FriesW/sauna-controller/logic_gates.png

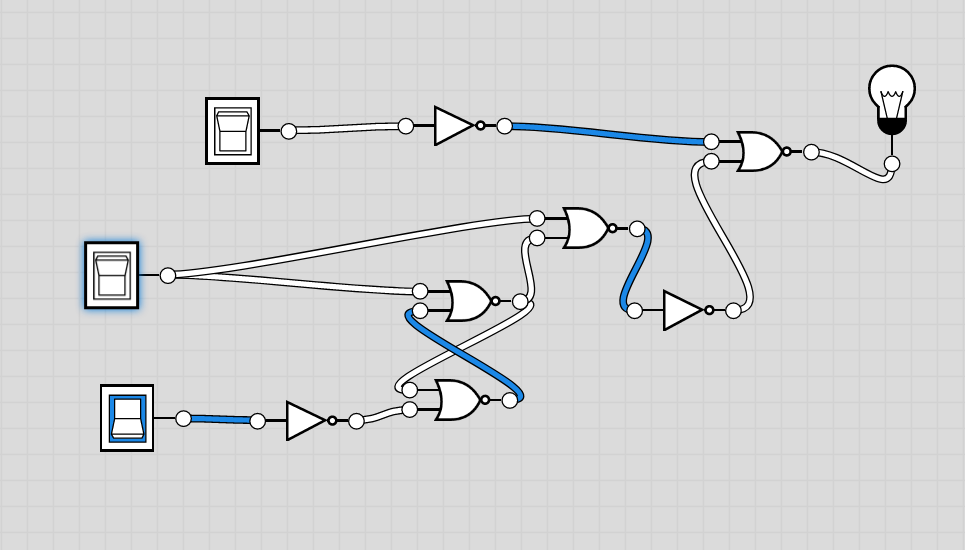
logic_gates.png
