FriesW/sauna-controller/bom.ods

Sheet: Draft
Sch id | Desc | Part # | Link
 | Switch reg | SRH05S12 | https://www.mouser.com/ProductDetail/XP-Power/SRH05S12/?qs=w%2Fv1CP2dgqoB4ok%252BZU%252BVXg%3D%3D
 | Relay | G5V-1-DC12 | https://www.mouser.com/ProductDetail/Omron-Electronics/G5V-1-DC12/
 | Relay | G5Q-1A4-DC12 | https://www.mouser.com/ProductDetail/Omron-Electronics/G5Q-1A4-DC12/?qs=pWf36BUtxBgkyTKYzHU%2F3Q%3D%3D
 | Linear reg | MC78M05CDTG | https://www.mouser.com/ProductDetail/ON-Semiconductor/MC78M05CDTG/?qs=%252B9%2Fcbd0IE0QYxnKZhiUfxQ%3D%3D
 | Rectifier | RABF154-13 | https://www.mouser.com/ProductDetail/Diodes-Incorporated/RABF154-13/?qs=%252BEew9%252B0nqrC87fSpOqlqqA%3D%3D
 | TVS | VESD05A5-06GHG3-08 | https://www.mouser.com/ProductDetail/Vishay-Semiconductors/VESD05A5-06GHG3-08/
 | Flyback Diode | 1N4148WS-HG3-08 | https://www.mouser.com/ProductDetail/Vishay-Semiconductors/1N4148WS-HG3-08/?qs=MLItCLRbWsz%2FnO5zs5RZvA%3D%3D
 | NPN BJT | BC816-25HVL | https://www.mouser.com/ProductDetail/Nexperia/BC816-25HVL/?qs=vmHwEFxEFR%2FYZAQE4AJJ1Q%3D%3D
 | NPN BJT | PMBT2222A,235 | https://www.mouser.com/ProductDetail/Nexperia/PMBT2222A235/?qs=LOCUfHb8d9sTD2Msxc7rRQ%3D%3D
 | Temp sensor | DS18B20+ | https://www.mouser.com/ProductDetail/Maxim-Integrated/DS18B20%2b/?qs=7H2Jq%252ByxpJKegCKabDbglA%3D%3D
 | Board temp sensor | MCP9701AT-E/TT | https://www.mouser.com/ProductDetail/Microchip-Technology/MCP9701AT-E-TT/?qs=yUQqVecv4qtCeX8rF6YxaA%3D%3D
 | Polyfuse | 0ZCF0030FF2C | https://www.mouser.com/ProductDetail/Bel-Fuse/0ZCF0030FF2C/
 | Fusable Resistor | ULW2-10RJA25 | https://www.mouser.com/ProductDetail/Welwyn-Components-TT-Electronics/ULW2-10RJA25/
 | 680 uF HV cap | ELXZ630ELL681MK35S | https://www.mouser.com/ProductDetail/United-Chemi-Con/ELXZ630ELL681MK35S/
 | 4.7 uF HV cap | HMR325AC7475KM-P | https://www.mouser.com/ProductDetail/Taiyo-Yuden/HMR325AC7475KM-P/
 | input inductor | ASPI-6045S-820M-T | https://www.mouser.com/ProductDetail/ABRACON/ASPI-6045S-820M-T/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
 | input inductor | ASPI-4030S-120M-T | https://www.mouser.com/ProductDetail/ABRACON/ASPI-4030S-120M-T/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
 | 220 uF HV cap | EEE-FK1J221AV | https://www.mouser.com/ProductDetail/Panasonic/EEE-FK1J221AV/?qs=4tMhz21N3ZGTStcmMQwx0g%3D%3D
 | 820 uF HV cap | EEE-TP70821M | https://www.mouser.com/ProductDetail/Panasonic/EEE-TP70821M/
 | Watchdog | MIC705MY | https://www.mouser.com/ProductDetail/Microchip-Technology-Micrel/MIC705MY/?qs=kh6iOki%2FeLGGkcTIfRHW3A%3D%3D
 | Temp Sensor | GA10K3A1IA | https://www.mouser.com/ProductDetail/Measurement-Specialties/GA10K3A1IA/?qs=kmv%2FWw32SUNTU3lVb2t0Rg%3D%3D
 | Temp Sensor | NTCLE100E3222HB0 | https://www.mouser.com/ProductDetail/Vishay-BC-Components/NTCLE100E3222HB0/?qs=%2FWiulJ9oly4N3QVFAv7XNQ%3D%3D
 | Temp Sensor | NJ28MA0302F-- | https://www.mouser.com/ProductDetail/AVX/NJ28MA0302F-/?qs=vhKgMu3aMmfBHN8kQbt0PA%3D%3D
 | Post reg cap | `865080445010 | https://www.mouser.com/ProductDetail/Wurth-Elektronik/865080445010/
 | TVS | SP0505BAHTG | https://www.mouser.com/ProductDetail/Littelfuse/SP0505BAHTG/?qs=%2FvxM1TNbkdRUGqLTdRy61Q%3D%3D
 | NOR gate | SN74HCS02DR | https://www.mouser.com/ProductDetail/Texas-Instruments/SN74HCS02DR/?qs=7MVldsJ5Uaytl4GhxY2CUQ%3D%3D

Sheet: Final
Symbol | Type | Footprint | Note | Part # | Link
C1 | 1000uF | Capacitor_SMD:CP_elec_16x17.5 | Custom footprint 9T, best match | EDH108M050A9TAA | https://www.mouser.com/ProductDetail/KEMET/EDH108M050A9TAA/?qs=E9QF1UCAUX68HR0xBmjG3Q%3D%3D
C2, C3, C4 | 220uF | Capacitor_SMD:CP_elec_10x10 | Custom footprint G, best match | EEE-FN1H221L | https://www.mouser.com/ProductDetail/Panasonic/EEE-FN1H221L/
C5, C6, C7, C8, C9, C10, C11 | 2.2uF | Capacitor:SMD:C_0805_2012Metric_Pad1.18x1.45mm_HandSolder | 0805/2012 | C0805C225Z4VACTU | https://www.mouser.com/ProductDetail/KEMET/C0805C225Z4VACTU/
D1 | Rectifier | Diode_SMD:Diode_bridge_Diotec_ABS | SOPA-4, best match | RABF154-13 | https://www.mouser.com/ProductDetail/Diodes-Incorporated/RABF154-13/?qs=%252BEew9%252B0nqrC87fSpOqlqqA%3D%3D
D2 | TVS | Package_TO_SOT_SMD:SOT-23-6_Handsoldering | SOT-23-6 | SP0505BAHTG | https://www.mouser.com/ProductDetail/Littelfuse/SP0505BAHTG/?qs=%2FvxM1TNbkdRUGqLTdRy61Q%3D%3D
D3 | Flyback | Diode_SMD:D_SOD-323_HandSoldering | SOD-323-2 | 1N4148WS-HG3-08 | https://www.mouser.com/ProductDetail/Vishay-Semiconductors/1N4148WS-HG3-08/?qs=MLItCLRbWsz%2FnO5zs5RZvA%3D%3D
D4, D5 | LED | LED_SMD:LED_0805_2012_Metric_Pad1.15x1.40mm_HandSolder | 0805/2012 | LTST-C171CKT | https://www.mouser.com/ProductDetail/Lite-On/LTST-C171CKT/?qs=Bxpkn1npXctIacYQWYwacA%3D%3D
F1, F2 | Fuse | Resistor_THT:R_axial_DIN0411_L9.9mm_D3.6mm_P12.70mm_Horizontal | 20.3 mm c-to-c TH | ULW2-10RJA25 | https://www.mouser.com/ProductDetail/Welwyn-Components-TT-Electronics/ULW2-10RJA25/
F3, F4, F5 | Polyfuse | Fuse:Fuse_2920_7451Metric_Pad2.10x5.45mm_HandSolder | 2920/7555 | 0ZCF0030FF2C | https://www.mouser.com/ProductDetail/Bel-Fuse/0ZCF0030FF2C/
F6 | Fuse | Fuse:Fuse_Littelfuse_395Series | Same footprint as Littelfuse 395 series | 39506300000 | https://www.mouser.com/ProductDetail/Littelfuse/39506300000/?qs=xDZNuFCSAK3%2F6BpQRTHisA%3D%3D
J1 | Pin connector | Connector_JST:JST_VH_B8P-VH_1x08_P3.96mm_Vertical | Measured existing connector | 26-20-2081 | https://www.mouser.com/ProductDetail/Molex/26-20-2081/?qs=Y%2FrI5Y8Al8%252BU1B17EHhcdQ%3D%3D | https://www.mouser.com/Connectors/Headers-Wire-Housings/_/N-ay0loZ1yzvvqxZscv7
K1 | Relay | Relay_THT:Relay_SPDT_Omron-G5Q-1 | SPST footprint is subset of SPDT | G5Q-1A4-EU DC12 | https://www.mouser.com/ProductDetail/Omron-Electronics/G5Q-1A4-EU-DC12/
L1 | Inductor | Inductor_SMD:L_Abracon_ASPI-0630LR |  | ASPI-0630LR-150M-T15 | https://www.mouser.com/ProductDetail/ABRACON/ASPI-0630LR-150M-T15/
Q1 | NPN BJT | Package_TO_SOT_SMD:SOT-23_Handsoldering | SOT-23-3 | PMBT2222A,235 | https://www.mouser.com/ProductDetail/Nexperia/PMBT2222A235/?qs=LOCUfHb8d9sTD2Msxc7rRQ%3D%3D
RN1, RN2 | 1k | Package_SO:SOIC-16_4.55x10.3mm_P1.27mm | Custom footprint SOM, best match | 4816P-1-102LF | https://www.mouser.com/ProductDetail/Bourns/4816P-1-102LF/?qs=XatseYaQfnp8nnZaPUObMg%3D%3D
RN3 | 330 | Package_SO:SOIC-16_4.55x10.3mm_P1.27mm | Custom footprint SOM, best match | 4816P-1-331LF | https://www.mouser.com/ProductDetail/Bourns/4816P-1-331LF/
RV1 | Varistor | Varistor:RV_Disc_D7mm_W3.6mm_P5mm | 5mm straight lead | V05E25P | https://www.mouser.com/ProductDetail/Littelfuse/V05E25P/?qs=fl1JHMt9NkMcXh4%2FlBz9QQ%3D%3D
TH1 | Thermistor | OptoDevice:R_LDR_4.9x4.2mm_P2.54mm_Vertical | 2.54mm straight lead, 2.8mm d sphere | NJ28MA0302F-- | https://www.mouser.com/ProductDetail/AVX/NJ28MA0302F-/?qs=vhKgMu3aMmfBHN8kQbt0PA%3D%3D
U1 | Linear reg | Package_TO_SOT_SMD:TO-252-2 | DPAK-3 CASE 369C → JEDEC TO-252 | MC78M05CDTG | https://www.mouser.com/ProductDetail/ON-Semiconductor/MC78M05CDTG/?qs=%252B9%2Fcbd0IE0QYxnKZhiUfxQ%3D%3D
U2 | Switch reg | Converter_DCDC:Converter_DCDC_RECOM_R-78B-2.0_THT | Custom THT | SRH05S12 | https://www.mouser.com/ProductDetail/XP-Power/SRH05S12/?qs=w%2Fv1CP2dgqoB4ok%252BZU%252BVXg%3D%3D
U3, U4 | NOR gate | Package_SO:SOIC-14_3.9x8.7mm_P1.27mm | SOIC-14 | SN74HCS02DR | https://www.mouser.com/ProductDetail/Texas-Instruments/SN74HCS02DR/?qs=7MVldsJ5Uaytl4GhxY2CUQ%3D%3D
U5 | Watchdog | Package_SO:SOIC-8_3.9x4.9mm_P1.27mm | SOIC-8 | MIC705MY | https://www.mouser.com/ProductDetail/Microchip-Technology-Micrel/MIC705MY/?qs=kh6iOki%2FeLGGkcTIfRHW3A%3D%3D
Fasteners
Spacer |  |  | RAF Electronic Hardware | NAS61-06B-050 | https://www.mouser.com/ProductDetail/RAF-Electronic-Hardware/NAS61-06B-050/?qs=wnTfsH77Xs7UieLzRXJ0Fg%3D%3D
Nut |  |  | Keystone Electronics | 9606 | https://www.mouser.com/ProductDetail/Keystone-Electronics/9606/?qs=g5fiFmky%2Fl5Js9ToeXLUpA%3D%3D
Bolt |  |  | Keystone Electronics | 9338 | https://www.mouser.com/ProductDetail/Keystone-Electronics/9338/?qs=xAjc%252BIZFyb7xItmqXzUvlg%3D%3D
