FriesW/sauna-controller/control_board/control_board.kicad_pcb

## KiCad design control_board/control_board.kicad_pcb (2021-02-15)

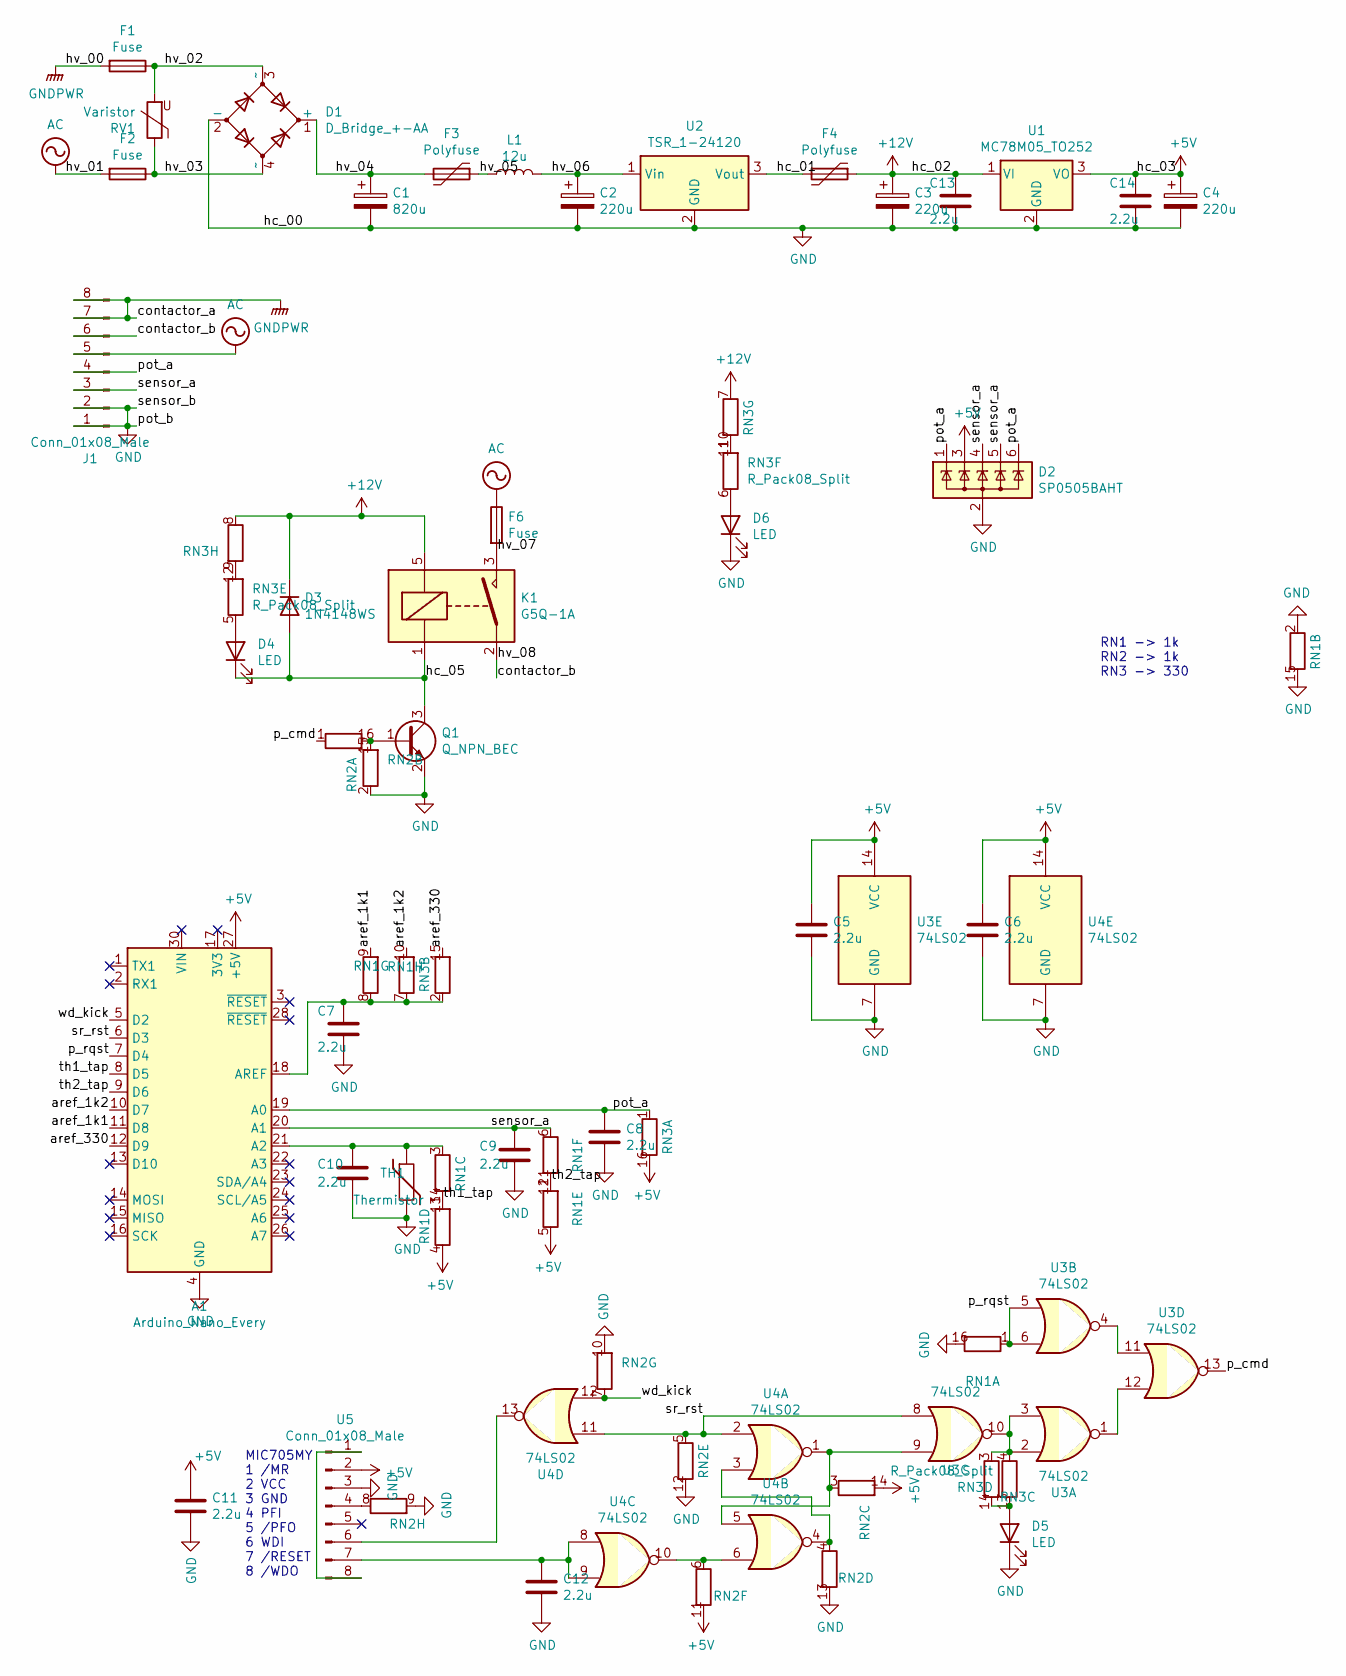
[picture p2: schematic control_board.sch]

Parts:
A1: Arduino_Nano_Every; Arduino_Nano
C1: 820u; CP_Elec_16x17.5
C2, C3, C4: 220u; CP_Elec_10x10
C5, C6, C7, C8, C9, C10, C11, C12, C13, C14: 2.2u; C_0805_2012Metric_Pad1.18x1.45mm_HandSolder
D1: D_Bridge_+-AA; Diode_Bridge_Diotec_ABS
D2: SP0505BAHT; SOT-23-6_Handsoldering
D3: 1N4148WS; D_SOD-323_HandSoldering
D4, D5, D6: LED; LED_0805_2012Metric_Pad1.15x1.40mm_HandSolder
F1, F2: Fuse; R_Axial_DIN0411_L9.9mm_D3.6mm_P12.70mm_Horizontal
F3, F4: Polyfuse; Fuse_2920_7451Metric_Pad2.10x5.45mm_HandSolder
F6: Fuse; Fuse_Littelfuse_395Series
J1: Conn_01x08_Male; JST_VH_B8P-VH_1x08_P3.96mm_Vertical
K1: G5Q-1A; Relay_SPDT_Omron-G5Q-1
L1: 12u; L_Abracon_ASPI-0630LR
Q1: Q_NPN_BEC; SOT-23_Handsoldering
RN1, RN2, RN3: R_Pack08_Split; SOIC-16_4.55x10.3mm_P1.27mm
RV1: Varistor; RV_Disc_D7mm_W3.6mm_P5mm
TH1: Thermistor; R_LDR_4.9x4.2mm_P2.54mm_Vertical
U1: MC78M05_TO252; TO-252-2
U2: TSR_1-24120; Converter_DCDC_RECOM_R-78B-2.0_THT
U3, U4: 74LS02; SOIC-14_3.9x8.7mm_P1.27mm
U5: Conn_01x08_Male; SOIC-8_3.9x4.9mm_P1.27mm

Connections:
+5V: A1.27 (+5V), C4.1, C5.1, C6.1, C11.1, C14.1, D2.3 (K), RN1.4 (R4.1), RN1.5 (R5.1), RN2.11 (R6.2), RN2.14 (R3.2), RN3.16 (R1.2), U1.3 (VO), U3.14 (VCC), U4.14 (VCC), U5.2
+12V: C3.1, C13.1, D3.1 (K), F4.1, K1.5, RN3.7 (R7.1), RN3.8 (R8.1), U1.1 (VI)
/aref_1k1: A1.11 (D8), RN1.9 (R8.2)
/aref_1k2: A1.10 (D7), RN1.10 (R7.2)
/aref_330: A1.12 (D9), RN3.15 (R2.2)
/contactor_b: J1.6, K1.2
/hc_01: F4.2, U2.3 (Vout)
/hc_05: D3.2 (A), D4.1 (K), K1.1, Q1.3 (C)
/hv_02: D1.3 (~~), F1.1, RV1.2
/hv_03: D1.4 (~~), F2.1, RV1.1
/hv_04: C1.1, D1.1 (+), F3.2
/hv_05: F3.1, L1.1
/hv_06: C2.1, L1.2, U2.1 (Vin)
/hv_07: F6.2, K1.3
/p_cmd: RN2.1 (R1.1), U3.13
/p_rqst: A1.7 (D4), RN1.1 (R1.1), U3.5, U3.6
/pot_a: A1.19 (A0), C8.1, D2.1 (K), D2.6 (K), J1.4, RN3.1 (R1.1)
/sensor_a: A1.20 (A1), C9.1, D2.4 (K), D2.5 (K), J1.3, RN1.6 (R6.1)
/sr_rst: A1.6 (D3), RN2.5 (R5.1), U3.8, U4.2, U4.11
/th1_tap: A1.8 (D5), RN1.13 (R4.2), RN1.14 (R3.2)
/th2_tap: A1.9 (D6), RN1.11 (R6.2), RN1.12 (R5.2)
/wd_kick: A1.5 (D2), RN2.7 (R7.1), U4.12
AC: F2.2, F6.1, J1.5
GND: A1.4 (GND), A1.29 (GND), C1.2, C2.2, C3.2, C4.2, C5.2, C6.2, C7.2, C8.2, C9.2, C10.2, C11.2, C12.2, C13.2, C14.2, D1.2 (-), D2.2 (A), D5.1 (K), D6.1 (K), J1.1, J1.2, Q1.2 (E), RN1.2 (R2.1), RN1.15 (R2.2), RN1.16 (R1.2), RN2.2 (R2.1), RN2.9 (R8.2), RN2.10 (R7.2), RN2.12 (R5.2), RN2.13 (R4.2), TH1.2, U1.2 (GND), U2.2 (GND), U3.7 (GND), U4.7 (GND), U5.3
GNDPWR: F1.2, J1.7, J1.8
unnamed: A1.18 (AREF), C7.1, RN1.7 (R7.1), RN1.8 (R8.1), RN3.2 (R2.1)
unnamed: A1.21 (A2), C10.1, RN1.3 (R3.1), TH1.1
unnamed: C12.1, U4.8, U4.9, U5.7
unnamed: D4.2 (A), RN3.5 (R5.1)
unnamed: D5.2 (A), RN3.13 (R4.2), RN3.14 (R3.2)
unnamed: D6.2 (A), RN3.6 (R6.1)
unnamed: Q1.1 (B), RN2.15 (R2.2), RN2.16 (R1.2)
unnamed: RN2.3 (R3.1), U3.9, U4.1, U4.5
unnamed: RN2.4 (R4.1), U4.3, U4.4
unnamed: RN2.6 (R6.1), U4.6, U4.10
unnamed: RN2.8 (R8.1), U5.4
unnamed: RN3.3 (R3.1), RN3.4 (R4.1), U3.2, U3.3, U3.10
unnamed: RN3.10 (R7.2), RN3.11 (R6.2)
unnamed: RN3.9 (R8.2), RN3.12 (R5.2)
unnamed: U3.1, U3.12
unnamed: U3.4, U3.11
unnamed: U4.13, U5.6
unnamed: U5.1, U5.8

Notes on the sheet:
RN1 -> 1k RN2 -> 1k RN3 -> 330
MIC705MY 1 /MR 2 VCC 3 GND 4 PFI 5 /PFO 6 WDI 7 /RESET 8 /WDO

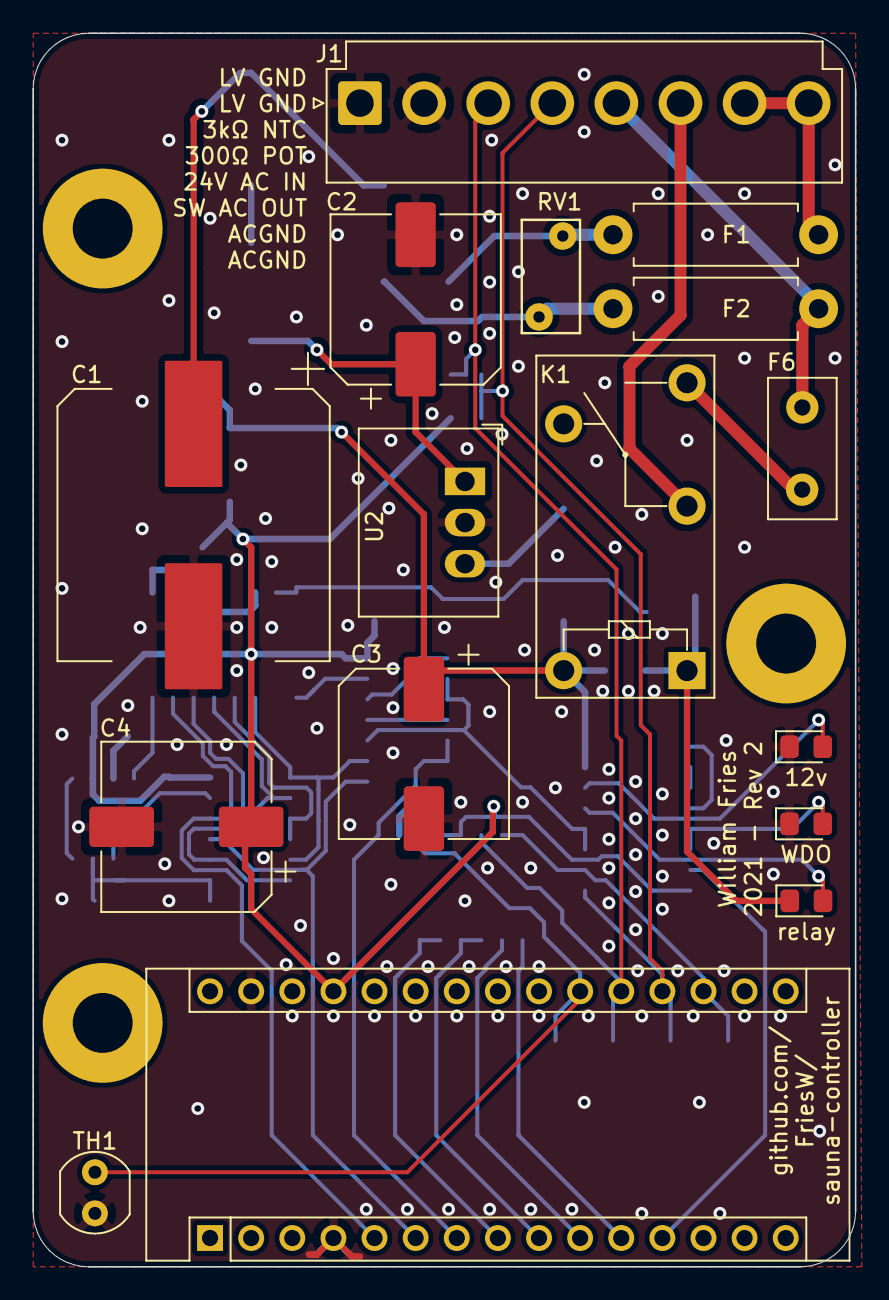
[picture p3: board control_board.kicad_pcb from above]

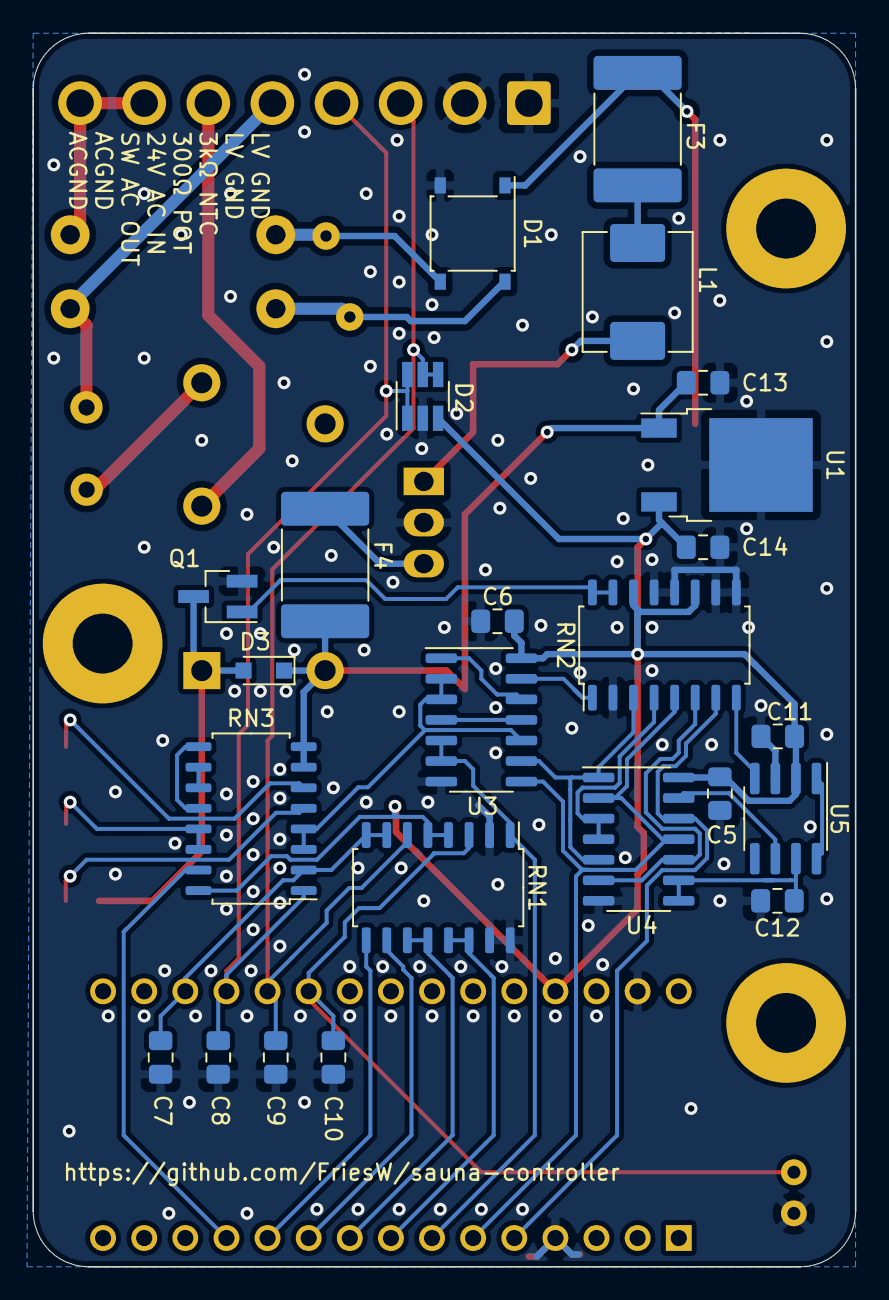
[picture p4: board control_board.kicad_pcb from below]

Board: 2 copper layers, 50.8 x 76.2 mm, 40 parts (24 on the bottom side), 43 nets.
