FriesW/sauna-controller/software/main/io.h

#ifndef _IO_H
#define _IO_H

#define P_RQST (4)
#define SR_RST (3)
#define WD_KICK (2)

#define BD_LED (13)

#define PCB_TEMP (16)
#define ROOM_TEMP (15)
#define POT (14)

#define PCB_TAP (5)
#define ROOM_TAP (6)

#define AREF_1K0 (7)
#define AREF_1K1 (8)
#define AREF_330 (9)

#endif
