FriesW/sauna-controller/(commit log)

2021-01-19 Initial commit, first PCB revision
    [PS_sim.kicad_pcb, PS_sim.sch, bom.ods, control_board.kicad_pcb, control_board.sch, temp_sensor.ods]
2021-01-20 Revised PCB layout
    [control_board.kicad_pcb, control_board.sch]
2021-01-20 Fix board perimeter and silkscreen component ids
    [control_board.kicad_pcb]
2021-01-20 Optimize some traces
    [control_board.kicad_pcb]
2021-01-20 Add actual mount holes
    [control_board.kicad_pcb]
2021-01-20 Ground plane via stitching
    [control_board.kicad_pcb]
2021-01-20 Silkscreen cleanup, DRC check, few more vias
    [control_board.kicad_pcb]
2021-01-21 Path and fill optimization
    [control_board.kicad_pcb]
2021-01-21 Prepare for JLCPCB
    [control_board.kicad_pcb]
2021-01-21 Finalize design
    [control_board.kicad_pcb]
2021-01-21 Add connector part and part search
    [bom.ods]
2021-01-21 Fix some DRC errors
    [control_board.kicad_pcb]
2021-01-21 Change LED silkscreen
    [control_board.kicad_pcb]
2021-01-21 Export gerber
    [control_board-B_Cu.gbr, control_board-B_Mask.gbr, control_board-B_SilkS.gbr, control_board-Edge_Cuts.gbr, control_board-F_Cu.gbr, control_board-F_Mask.gbr, control_board-F_SilkS.gbr, control_board-job.gbrjob]
2021-01-22 Adjust mounting points
    [control_board.kicad_pcb]
2021-01-22 Remove gerber folder
    [control_board-B_Cu.gbr, control_board-B_Mask.gbr, control_board-B_SilkS.gbr, control_board-Edge_Cuts.gbr, control_board-F_Cu.gbr, control_board-F_Mask.gbr, control_board-F_SilkS.gbr, control_board-job.gbrjob]
2021-01-22 New mount hole spacing, new layout
    [control_board.kicad_pcb, control_board.sch]
2021-01-24 Find mounting hardware
    [bom.ods]
2021-01-28 BOM Updates
    Swap F1 & F2 fusable resistors to lower wattage
    Swap F6 fuse to in stock fuse, actually Littelfuse 395 series
    [bom.ods]
2021-02-05 PCB revision notes
2021-02-08 Draft: SW decode thermistor
2021-02-09 Fix analog read init bug
    [analog.cpp]
2021-02-11 Fix compare bug, comment on AREF
    [analog.cpp, util.cpp]
2021-02-13 Spreadsheet other pot options
    [temp_sensor.ods]
2021-02-13 Revise schematic and some footprints
    [bom.ods, control_board.sch]
2021-02-13 Round PCB corners
    [control_board.kicad_pcb, control_board.sch]
2021-02-13 Reduce width of C1 pads
    [control_board.kicad_pcb]
2021-02-13 Draft layout
    [control_board.kicad_pcb, control_board.sch]
2021-02-13 Draft logic layout
    [control_board.kicad_pcb, control_board.sch]
2021-02-13 Layout almost done
    [control_board.kicad_pcb, control_board.sch]
2021-02-13 Layout complete
    TODO
    Via stitch ground
    Fix silkscreen positions
    Final check of revision notes
    [control_board.kicad_pcb, control_board.sch]
2021-02-13 PCB Rev2 Complete
    [control_board.kicad_pcb]
2021-02-14 Via & trace tweaks
    [control_board.kicad_pcb, control_board.sch]
2021-02-14 Fix silkscreen typo
    [control_board.kicad_pcb]
2021-02-15 Fix right edge cut
    [control_board.kicad_pcb]
2021-06-05 Board assembly notes
2021-06-05 Reading ADC values
2021-06-05 Convert readings to actual resistance
2021-06-05 NTC resistence to temperature conversion
2021-06-06 Tweak values, fix thermostat addition, maintain errors instead of defaults
    [analog.cpp, main.ino, thermostat.cpp]
2021-06-06 Fix first on delay and short cycle checks in thermostat
    [thermostat.cpp]
